XiaotianGuan/OMiGaS_KiCAD/sticker2.bmp

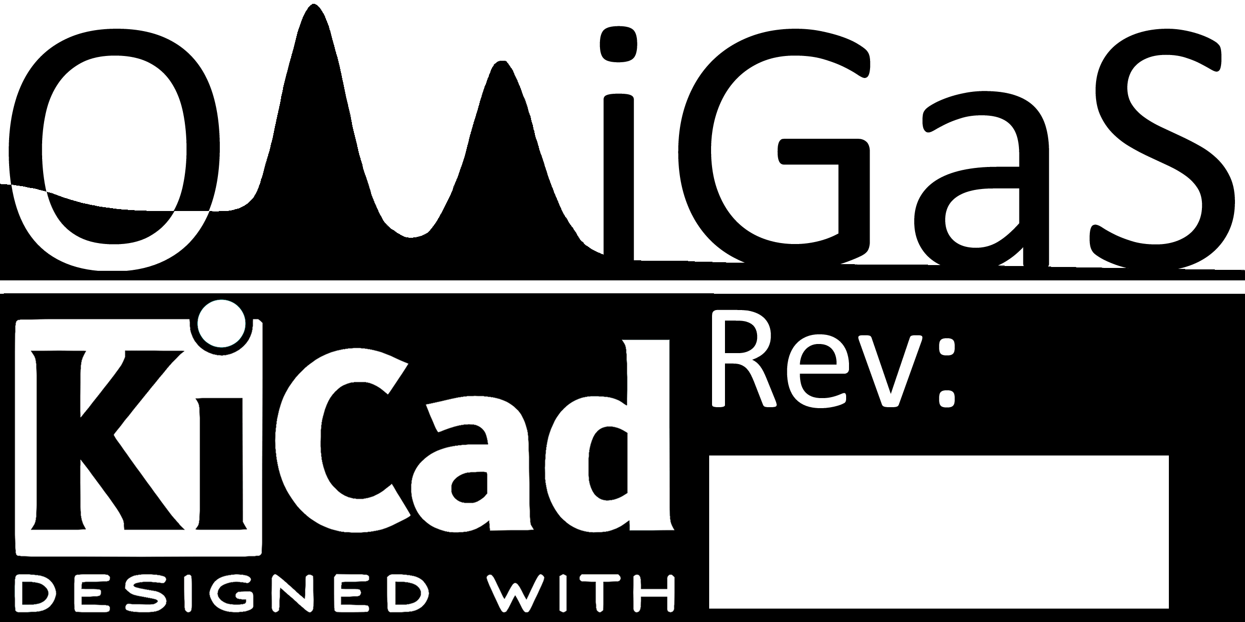
sticker2.bmp
