XiaotianGuan/OMiGaS_KiCAD/urlm.bmp

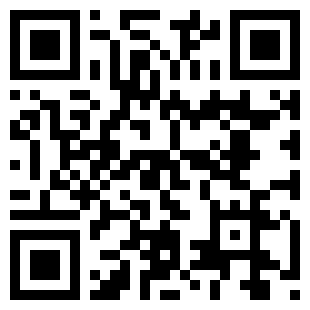
urlm.bmp
