XiaotianGuan/OMiGaS_KiCAD/OMiGaS_3D/SMB-vertical.step

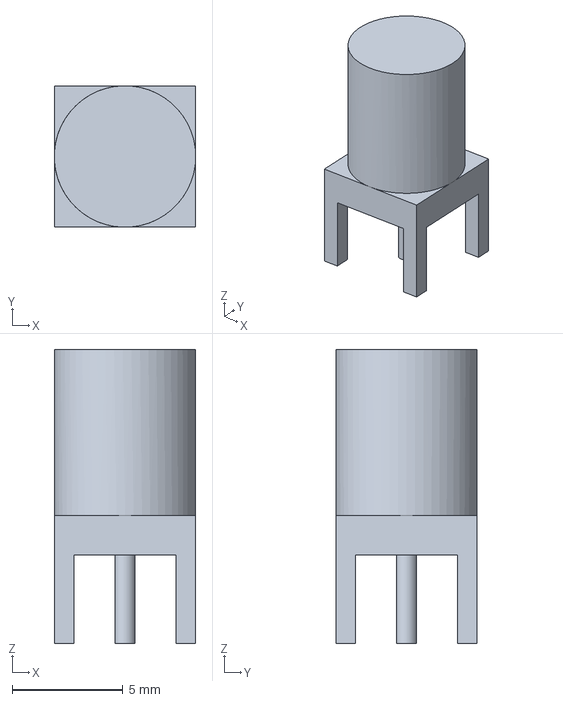
[picture p3: CAD file, 2024-07-17]
OMiGaS_3D/SMB-vertical.step
6.40 x 6.40 x 13.3 mm
