XiaotianGuan/OMiGaS_KiCAD/OMiGaS_3D/LT3462.stp

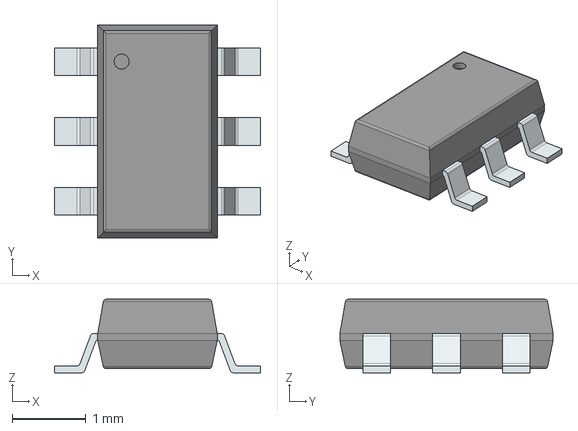
[picture p4: CAD file, 2024-07-17]
OMiGaS_3D/LT3462.stp
2.80 x 2.90 x 1.00 mm
PinsArrayLR
