XiaotianGuan/OMiGaS_KiCAD/OMiGaS_3D/M24Cxx.stp

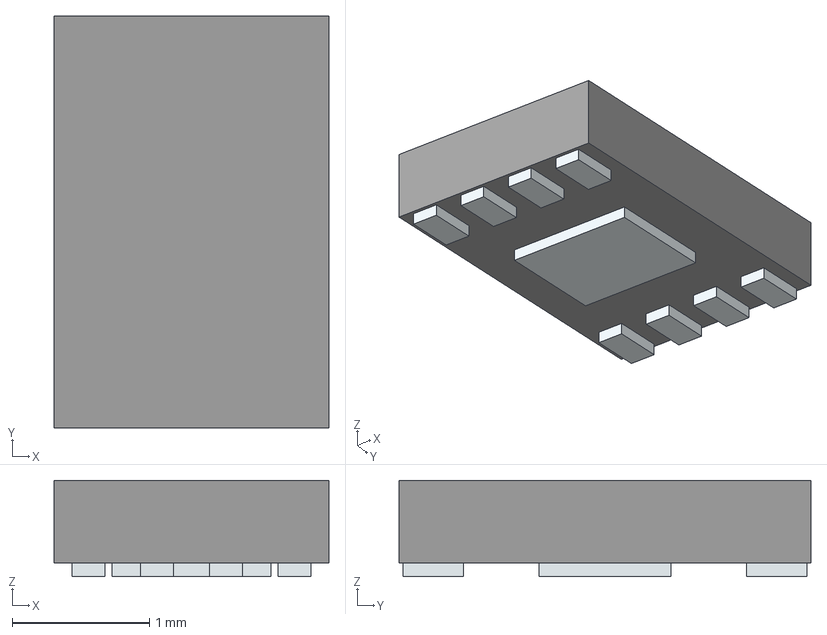
[picture p5: CAD file, 2024-07-17]
OMiGaS_3D/M24Cxx.stp
2.00 x 3.00 x 0.7 mm
Pins
