XiaotianGuan/OMiGaS_KiCAD/OMiGaS_3D/74LVC1G17.stp

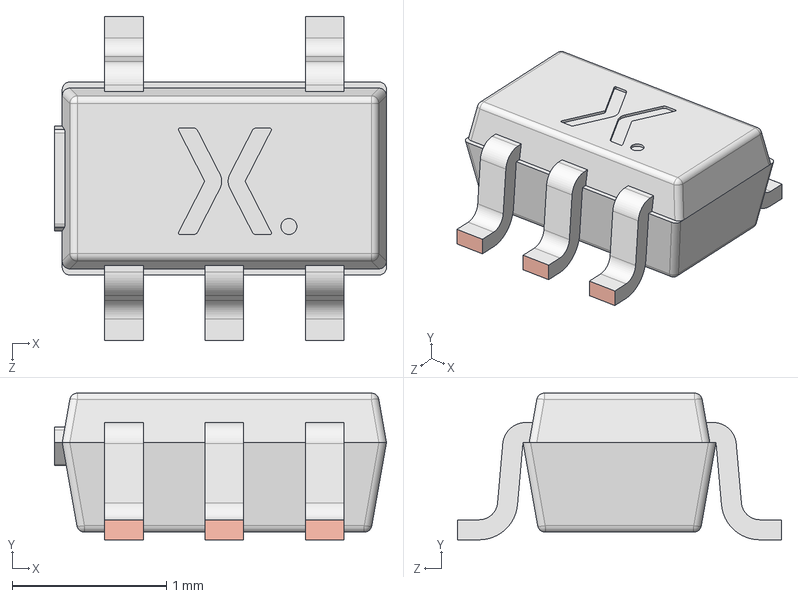
[picture p6: CAD file, 2024-07-17]
OMiGaS_3D/74LVC1G17.stp
2.15 x 0.95 x 2.10 mm
SOT353-1 Lower body
SOT353-1 Lead x 5
SOT353-1 Upper body
