XiaotianGuan/OMiGaS_KiCAD/OMiGaS_3D/MICROFC-60035.STEP

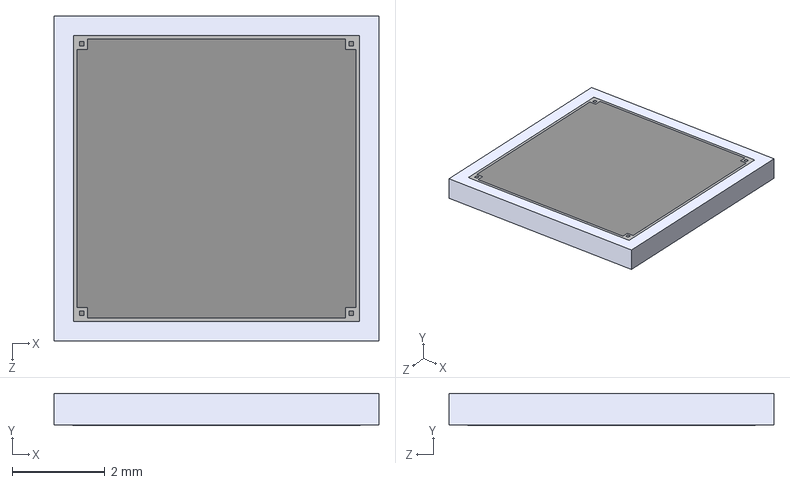
[picture p7: CAD file, 2024-07-17]
OMiGaS_3D/MICROFC-60035.STEP
7.00 x 0.7 x 7.00 mm
