XiaotianGuan/OMiGaS_KiCAD/OMiGaS_3D/TMP117.stp

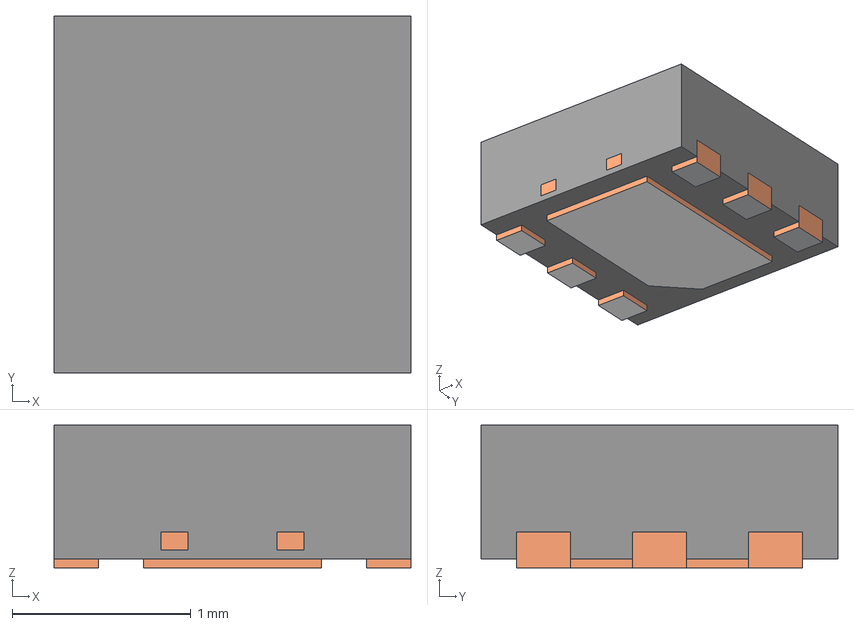
[picture p8: CAD file, 2024-07-17]
OMiGaS_3D/TMP117.stp
2.00 x 2.00 x 0.8 mm
BODY-SON
FRAME-DRV0006A
PIN1-ID
