XiaotianGuan/OMiGaS_KiCAD/OMiGaS_3D/TMP6331DYAR.stp

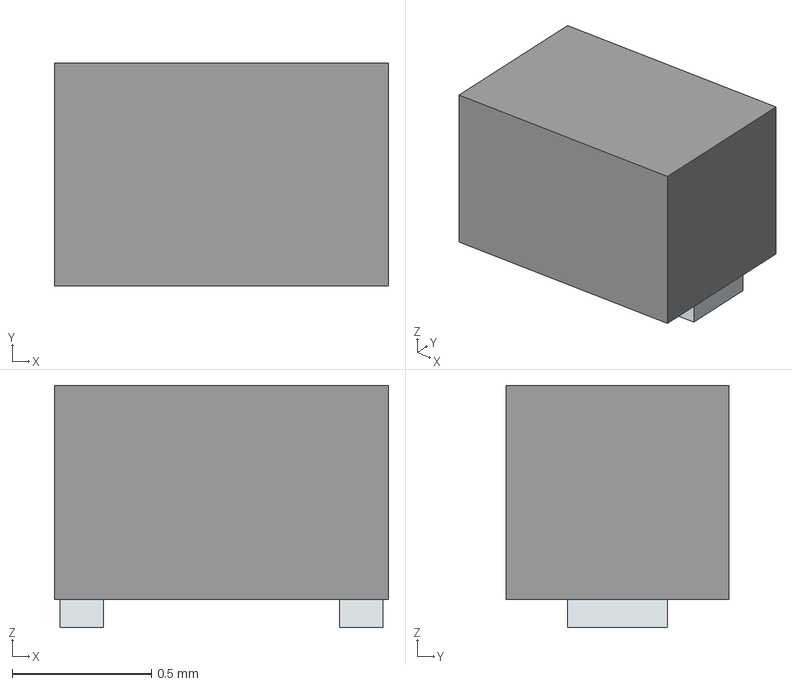
[picture p9: CAD file, 2024-07-17]
OMiGaS_3D/TMP6331DYAR.stp
1.20 x 0.8 x 0.87 mm
Pins
