XiaotianGuan/OMiGaS_KiCAD/OMiGaS_3D/VLCF5020T-470MR40.stp

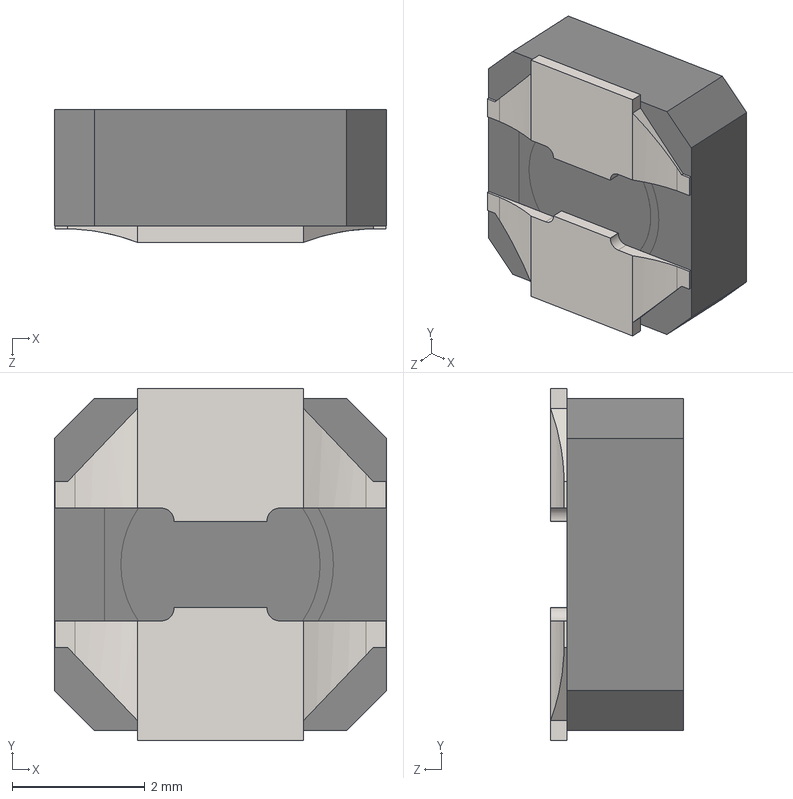
[picture p10: CAD file, 2024-07-17]
OMiGaS_3D/VLCF5020T-470MR40.stp
5.00 x 5.30 x 2.00 mm
