XiaotianGuan/OMiGaS_KiCAD/OMiGaS_3D/SW_sidemount_1P1T_3x6x3.5.step

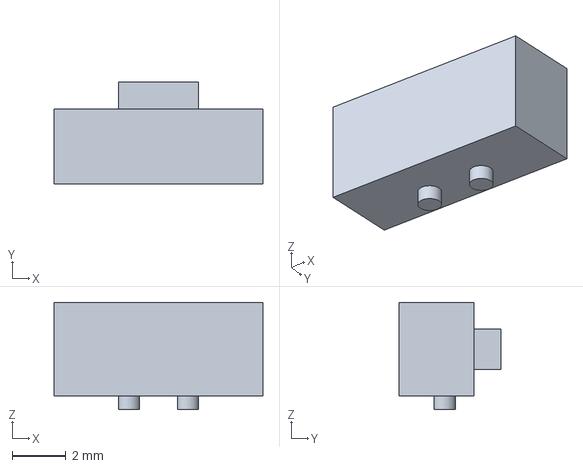
[picture p11: CAD file, 2024-07-17]
OMiGaS_3D/SW_sidemount_1P1T_3x6x3.5.step
7.80 x 3.80 x 4.00 mm
