XiaotianGuan/OMiGaS_KiCAD/OMiGaS_3D/CAT16-1003F4LF.stp

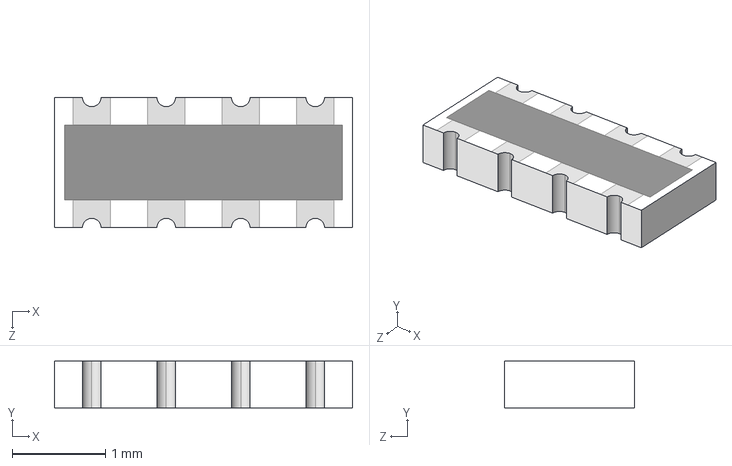
[picture p12: CAD file, 2024-07-17]
OMiGaS_3D/CAT16-1003F4LF.stp
3.20 x 0.5 x 1.40 mm
