XiaotianGuan/OMiGaS_KiCAD/OMiGaS_3D/3224W.stp

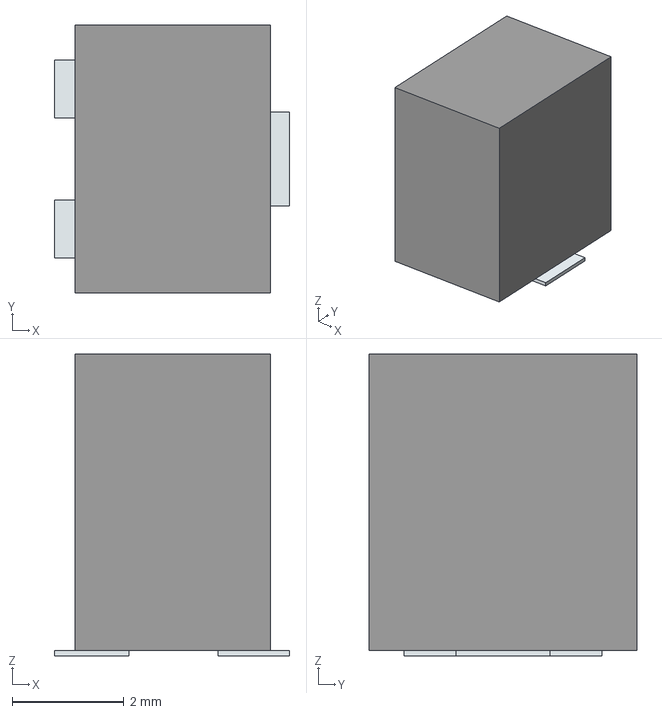
[picture p13: CAD file, 2024-07-17]
OMiGaS_3D/3224W.stp
4.21 x 4.80 x 5.40 mm
Pins
