XiaotianGuan/OMiGaS_KiCAD/OMiGaS_3D/TPS7A2045PDBVR.stp

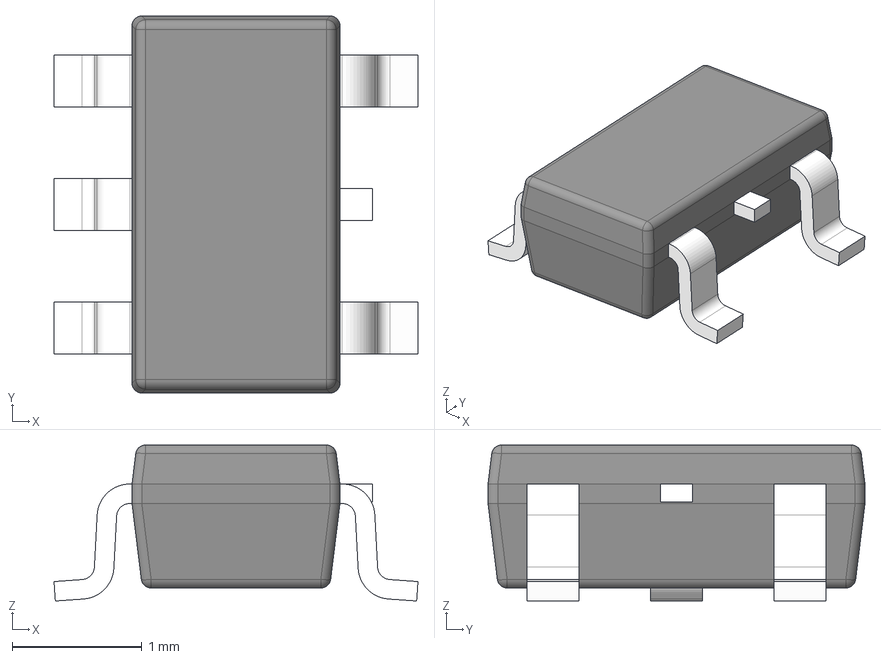
[picture p14: CAD file, 2024-07-17]
OMiGaS_3D/TPS7A2045PDBVR.stp
2.80 x 2.90 x 1.20 mm
BODY-SOT
LEAD-SOT x 5
LEAD-DUMMY
