XiaotianGuan/OMiGaS_KiCAD/OMiGaS_3D/detector-casing.step

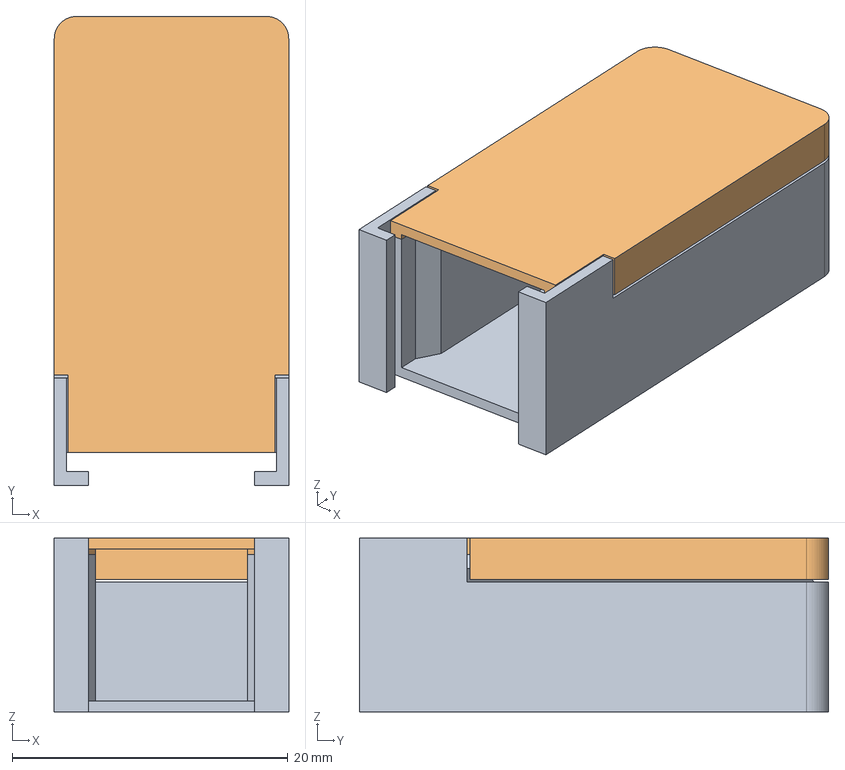
[picture p15: CAD file, 2024-07-17]
OMiGaS_3D/detector-casing.step
17.0 x 34.0 x 12.6 mm
detector-bottom
detector-top
