XiaotianGuan/OMiGaS_KiCAD/OMiGaS_3D/thumbwheel_3p.step

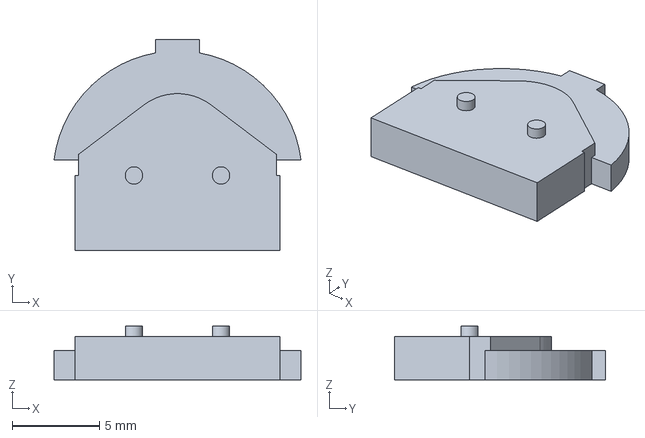
[picture p16: CAD file, 2024-07-17]
OMiGaS_3D/thumbwheel_3p.step
14.2 x 12.1 x 3.10 mm
