XiaotianGuan/OMiGaS_KiCAD/OMiGaS_3D/epd-2in66.step

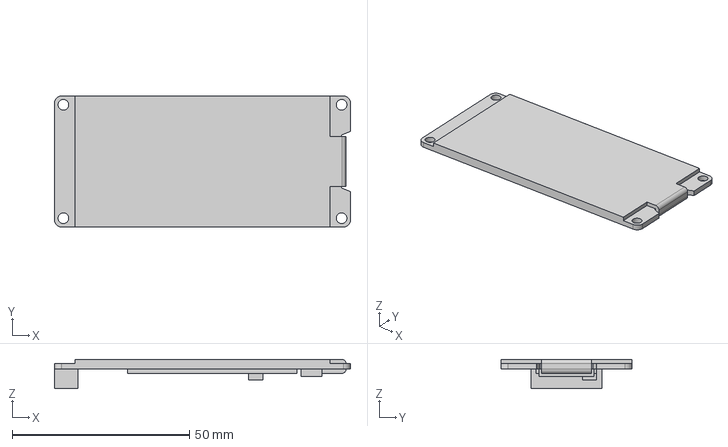
[picture p17: CAD file, 2024-07-17]
OMiGaS_3D/epd-2in66.step
83.5 x 37.0 x 8.30 mm
