XiaotianGuan/OMiGaS_KiCAD/OMiGaS_3D/MCP6006R.stp

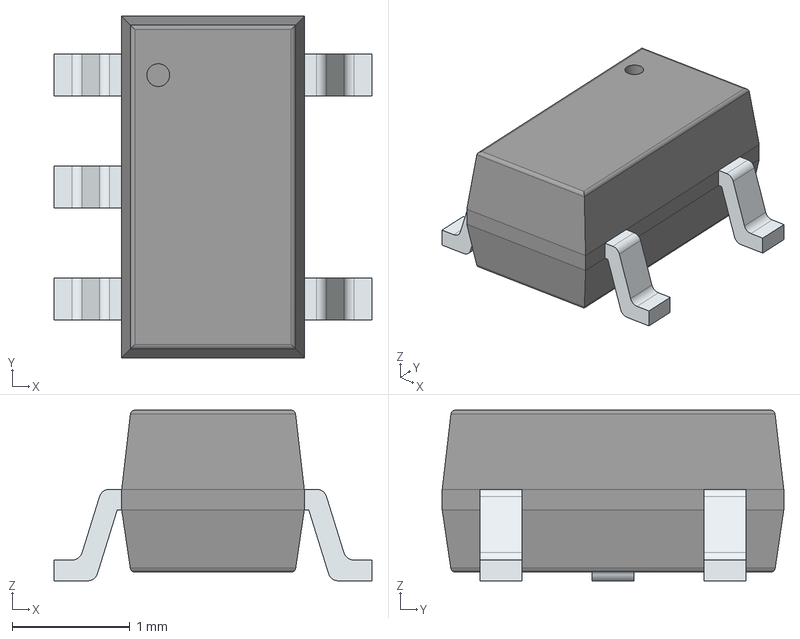
[picture p18: CAD file, 2024-07-17]
OMiGaS_3D/MCP6006R.stp
2.70 x 2.90 x 1.45 mm
PinsArrayL
PinsArrayR
