XiaotianGuan/OMiGaS_KiCAD/OMiGaS_3D/Buzzer-0905.step

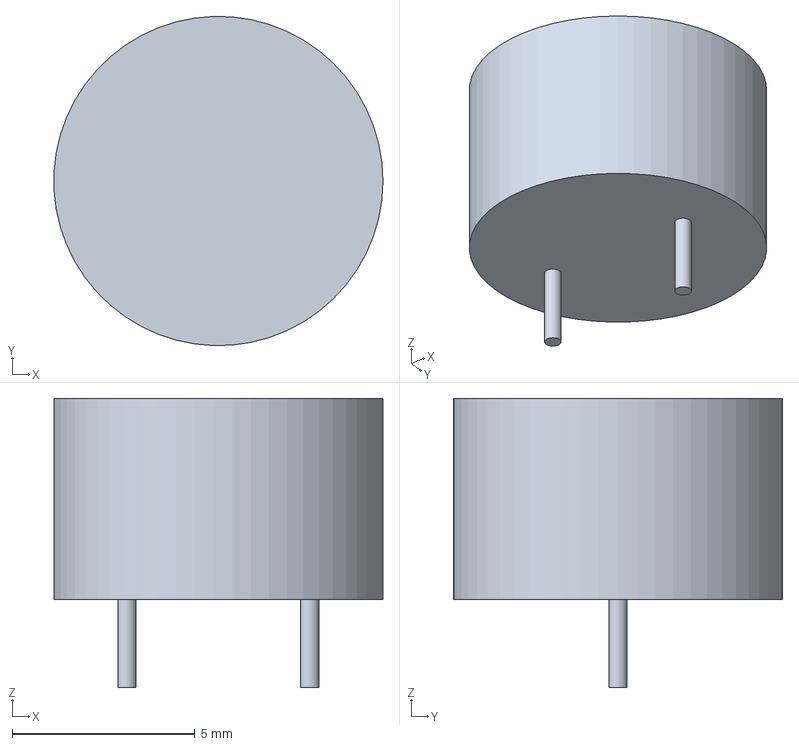
[picture p19: CAD file, 2024-07-17]
OMiGaS_3D/Buzzer-0905.step
8.99 x 9.00 x 7.90 mm
