XiaotianGuan/OMiGaS_KiCAD/OMiGaS_3D/DCT0008A.stp

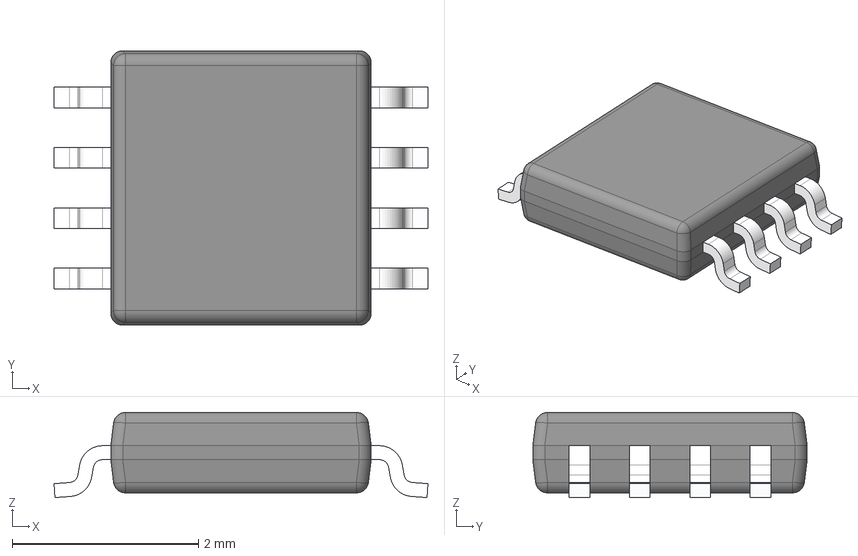
[picture p20: CAD file, 2024-07-17]
OMiGaS_3D/DCT0008A.stp
4.02 x 2.95 x 0.915 mm
BODY-SO
LEAD-SO x 8
PIN1-ID
