XiaotianGuan/OMiGaS_KiCAD/OMiGaS_3D/35W.stp

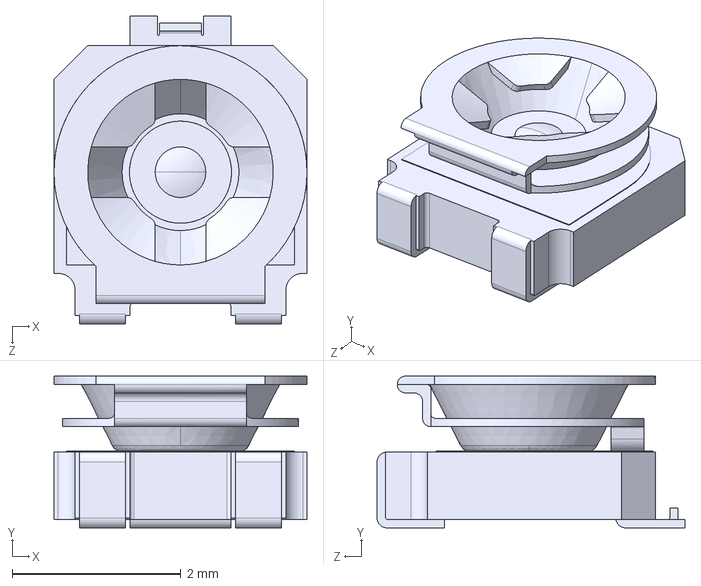
[picture p21: CAD file, 2024-07-17]
OMiGaS_3D/35W.stp
3.00 x 1.80 x 3.65 mm
