XiaotianGuan/OMiGaS_KiCAD/(list of files, cad)

Other CAD files:
OMiGaS_3D/524651070.stp
OMiGaS_3D/533091070.stp
OMiGaS_3D/MAX16150.stp
OMiGaS_3D/MAX31329.step
OMiGaS_3D/TLV61070A.stp
OMiGaS_3D/TPS22919DCKR.stp
