XiaotianGuan/OMiGaS_KiCAD/OMiGaS_schematics_v3.3.1.pdf

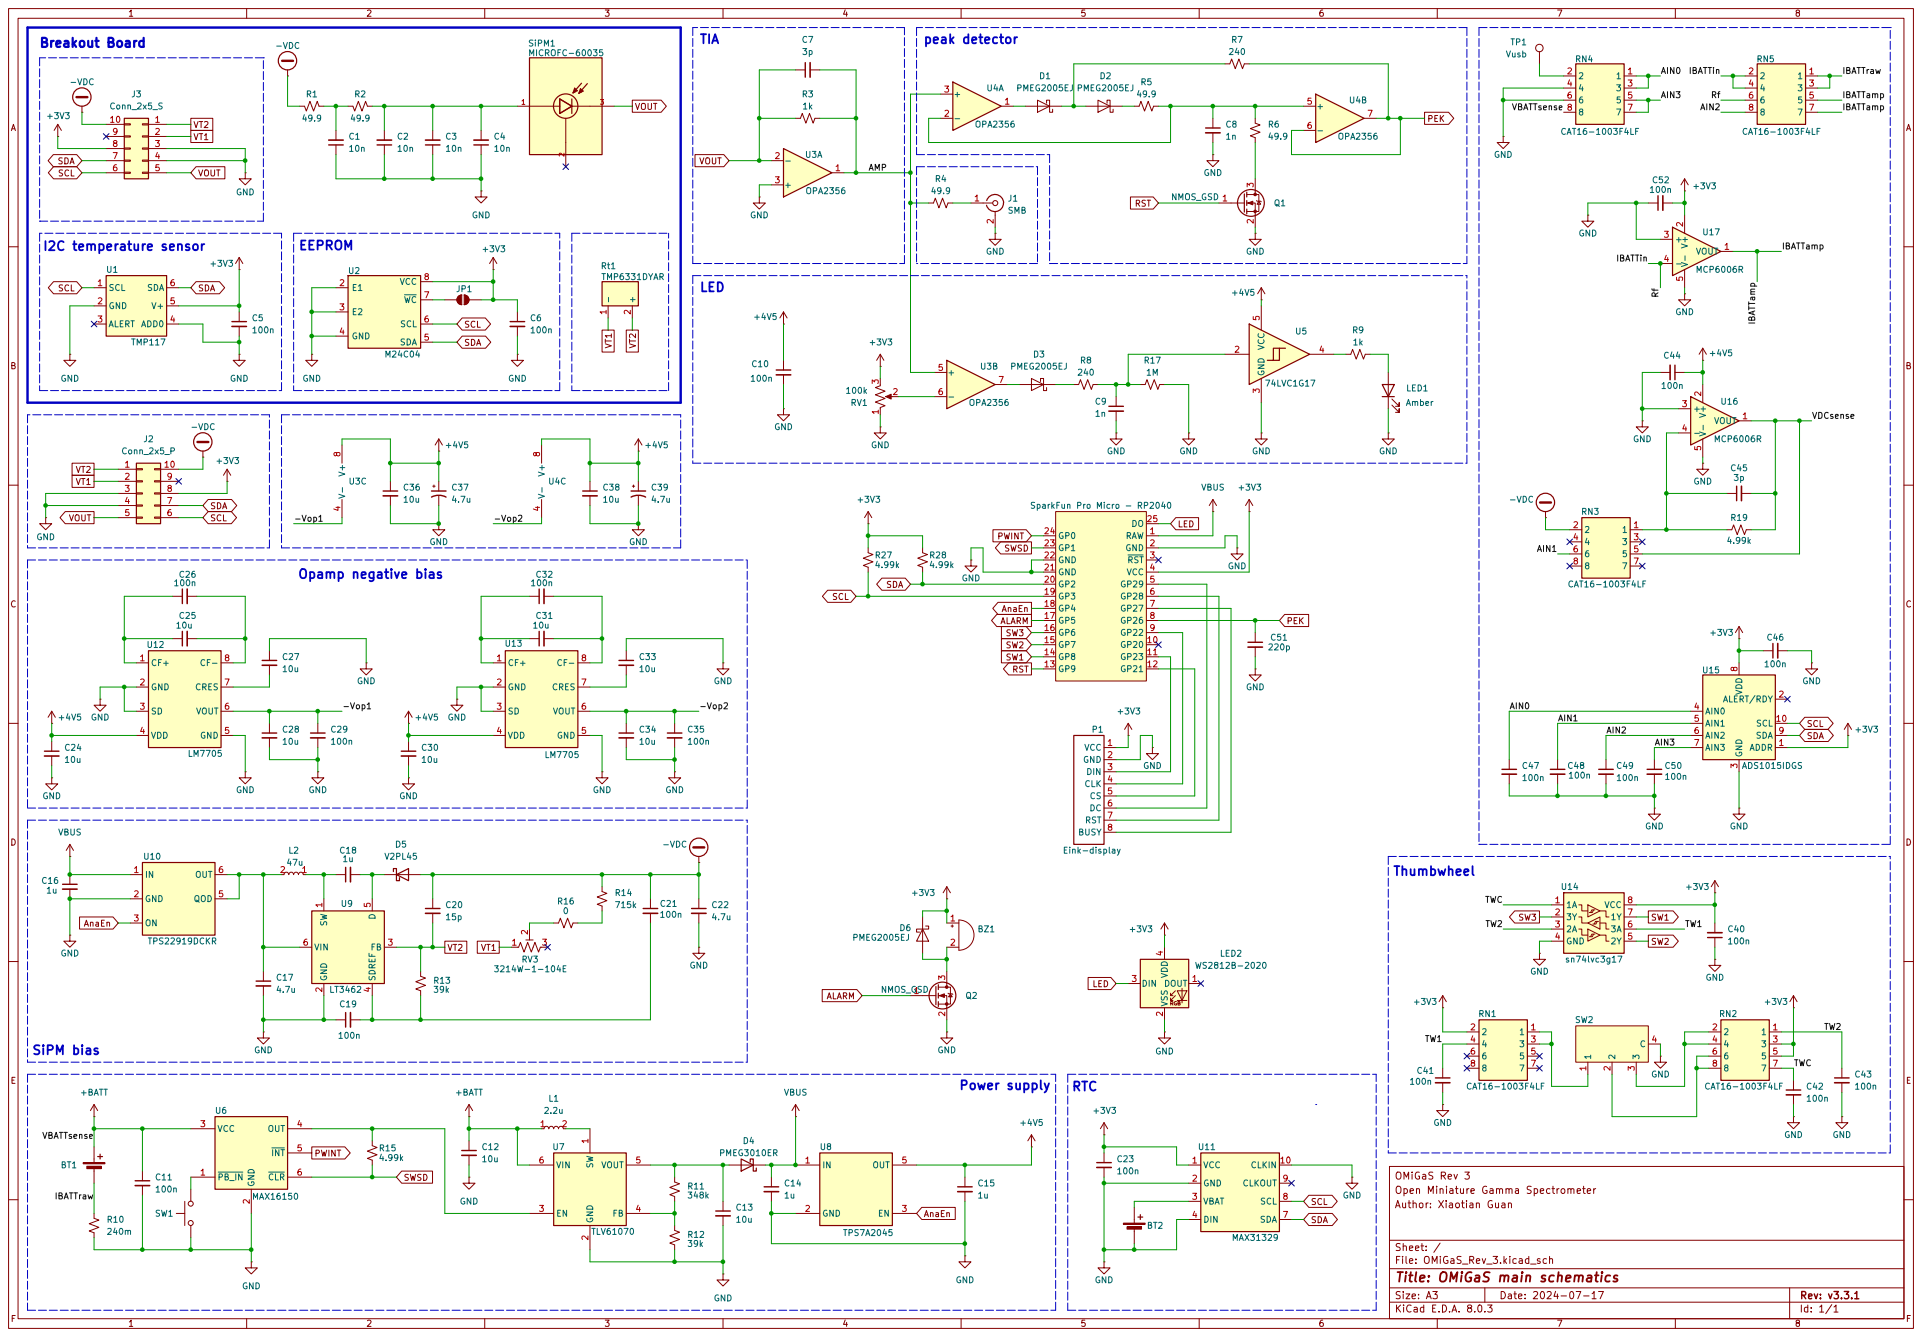
[picture p22: page 1]
