XiaotianGuan/OMiGaS_KiCAD/OMiGaS_Rev_3.kicad_pcb

## KiCad design OMiGaS_Rev_3.kicad_pcb (2024-12-22)

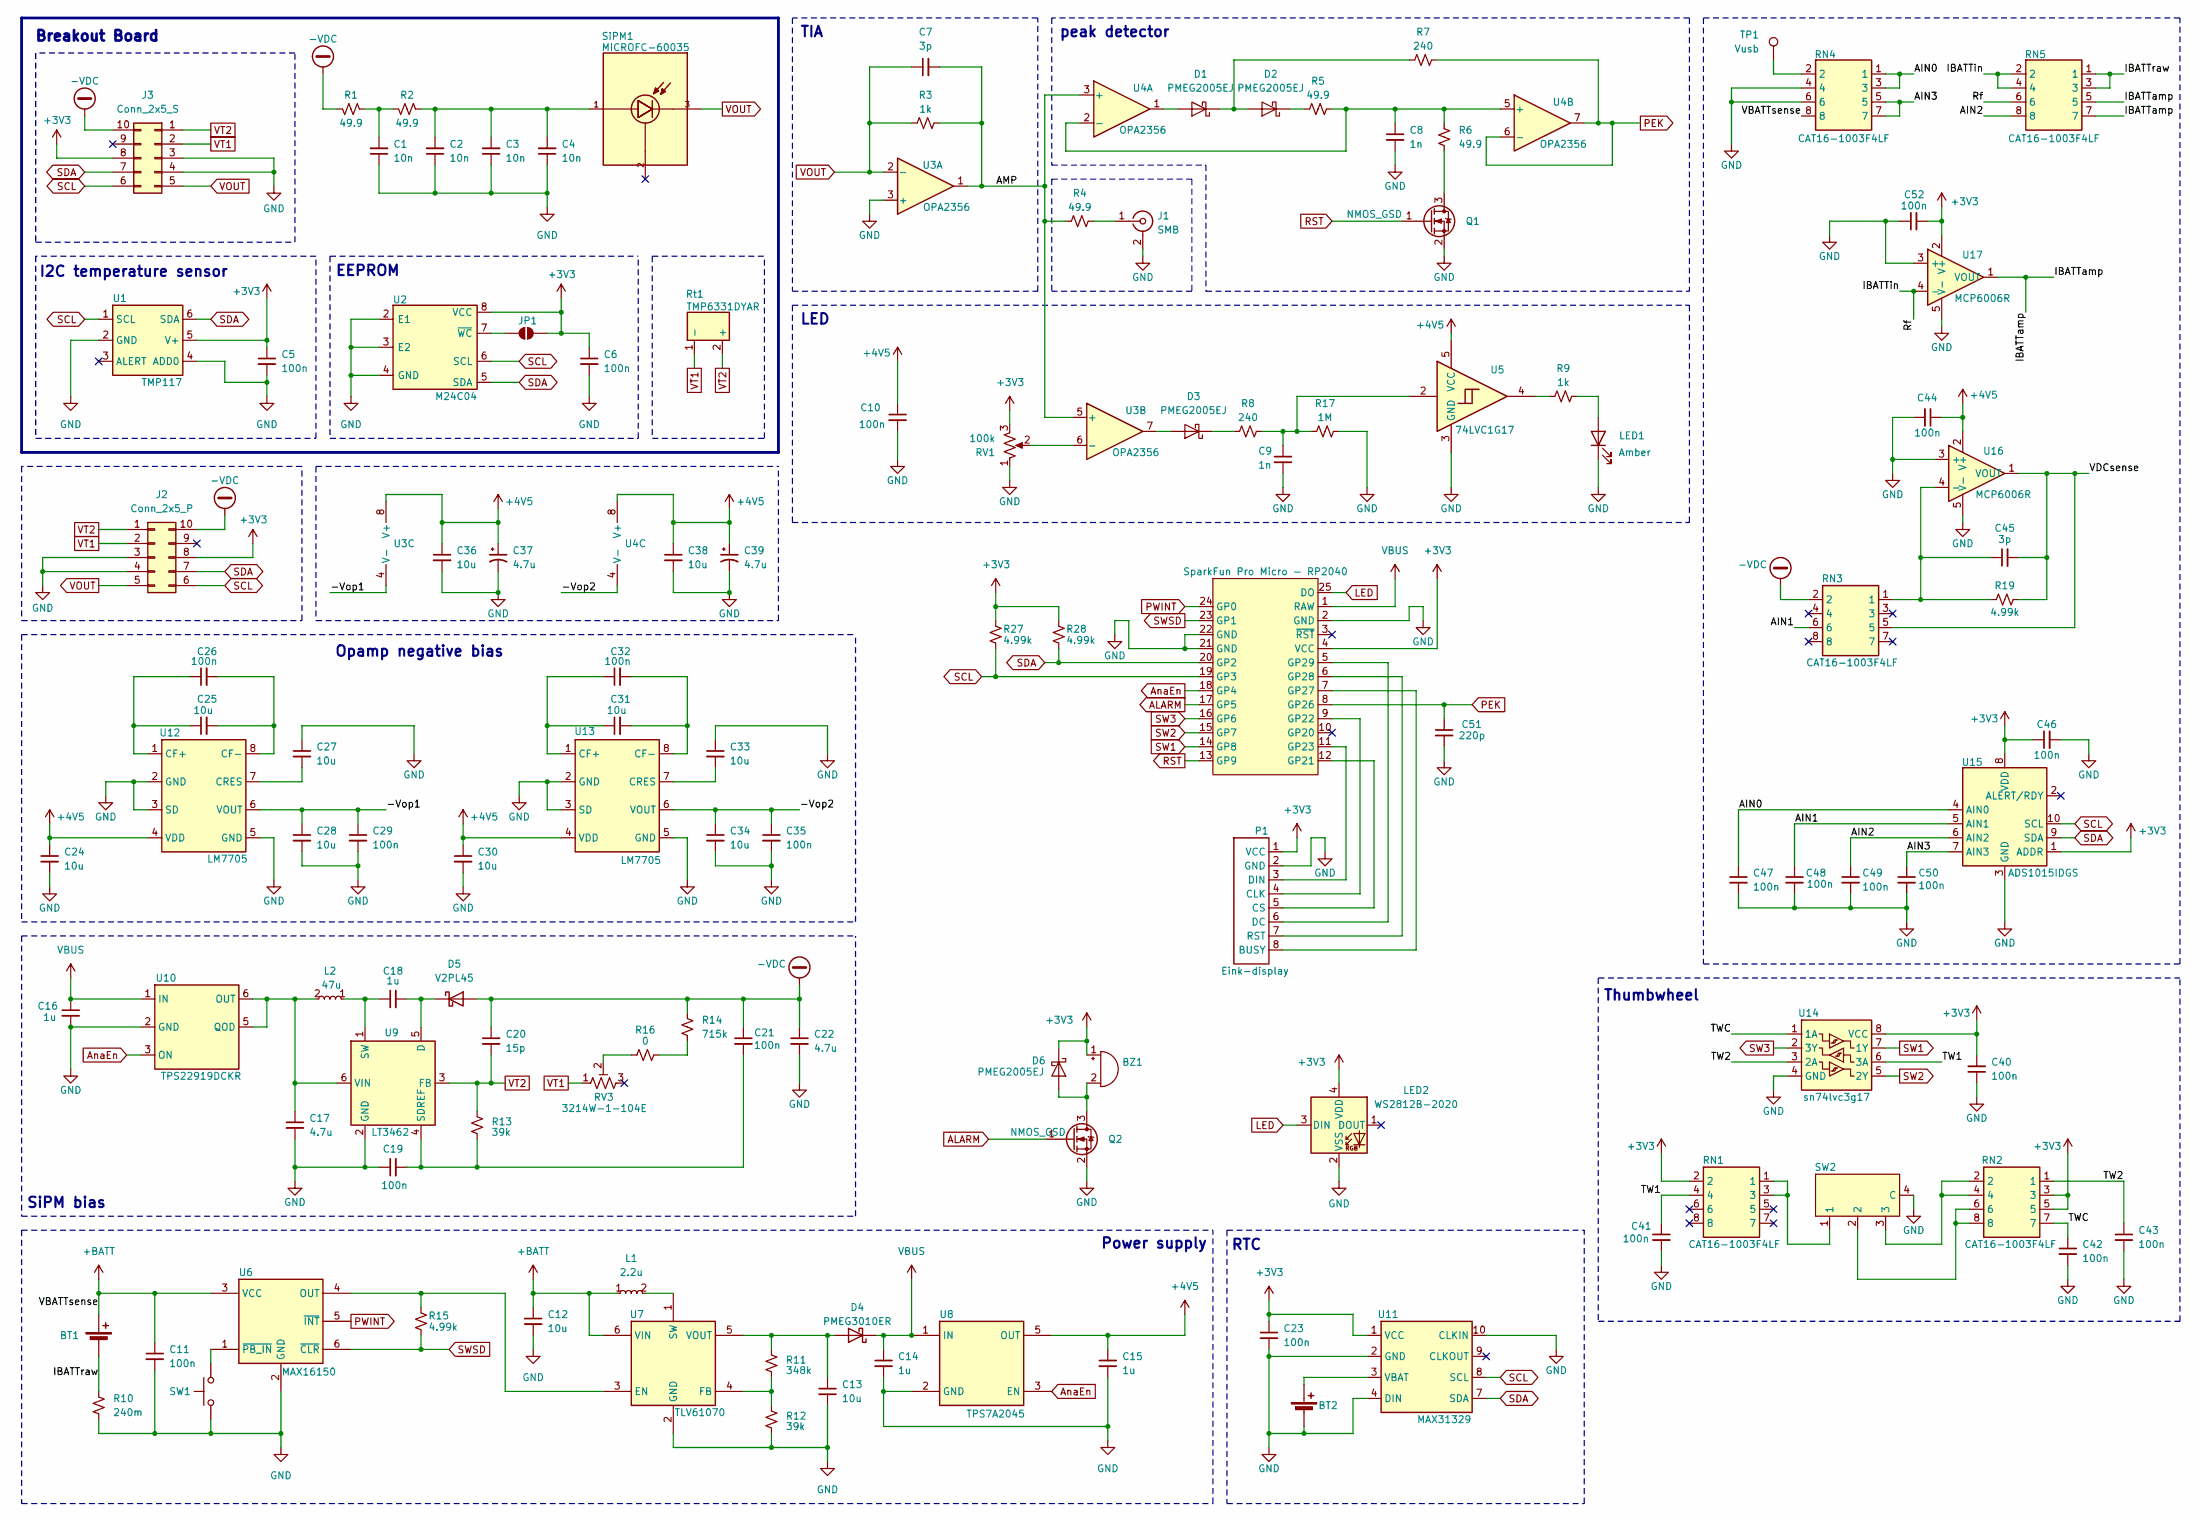
[picture p23: schematic OMiGaS_Rev_3.kicad_sch, OMiGaS main schematics]

Parts:
A1: SparkFun Pro Micro - RP2040
BT1: Battery_Cell; TestPoint_2Pads_Pitch2.54mm_Drill0.8mm
BT2: Battery_Cell; BatteryHolder_LINX_BAT-HLD-012-SMT; Manufacturer_Part_Number BAT-HLD-012-SMT
BZ1: Buzzer; Buzzer-0905
C1, C2, C3, C4: 10n; C_0603_1608Metric; Manufacturer_Part_Number C1608C0G2A103J080AC
C5, C6, C10, C11, C19, C21, C23, C26, C29, C32, C35, C40, C41, C42, C43, C44, C46, C47, C48, C49, C50, C52: 100n; C_0603_1608Metric
C7, C45: 3p; C_0603_1608Metric
C8: 1n; C_0603_1608Metric; Manufacturer_Part_Number ECH-U1C102GX5
C9: 1n; C_0603_1608Metric
C12, C13, C24, C25, C27, C28, C30, C31, C33, C34, C36, C38: 10u; C_0805_2012Metric
C14, C15, C16: 1u; C_0603_1608Metric
C17, C22: 4.7u; C_0805_2012Metric
C18: 1u; C_0805_2012Metric
C20: 15p; C_0805_2012Metric
C37, C39: 4.7u; CP_EIA-3216-18_Kemet-A; Manufacturer_Part_Number TPSA475M010R1400
C51: 220p; C_0603_1608Metric
D1, D2, D3, D6: PMEG2005EJ; D_SOD-323F; Manufacturer_Part_Number PMEG2005EJ-QX
D4: PMEG3010ER; Nexperia_CFP3_SOD-123W; Manufacturer_Part_Number PMEG3010ER,115
D5: V2PL45; D_TUMD2; Manufacturer_Part_Number V2PL45HM3/H
J1: SMB; smb-vertical
J2: Conn_2x5_P; LB100-G10P-C0R
J3: Conn_2x5_S; LB100-G10S-C0R
JP1: SolderJumper_2_Open; SolderJumper-2_P1.3mm_Open_RoundedPad1.0x1.5mm
L1: 2.2u; NRS5024T2R2NMGJ; Manufacturer_Part_Number NRS5024T2R2NMGJ
L2: 47u; VLCF5020; Manufacturer_Part_Number VLCF5020T-470MR40
LED1: Amber; LED_0603_1608Metric_Pad1.05x0.95mm_HandSolder; Manufacturer_Part_Number 150060AS75000
LED2: WS2812B-2020; LED_WS2812B-2020_PLCC4_2.0x2.0mm
P1: Eink-display; Eink_display
Q1, Q2: NMOS_GSD; SOT-23; Manufacturer_Part_Number T2N7002AK,LM
R1, R2, R4, R5, R6: 49.9; R_0805_2012Metric
R3, R9: 1k; R_0805_2012Metric
R7, R8: 240; R_0805_2012Metric
R10: 240m; R_1206_3216Metric
R11: 348k; R_0805_2012Metric
R12, R13: 39k; R_0805_2012Metric
R14: 715k; R_0805_2012Metric
R15, R19, R27, R28: 4.99k; R_0805_2012Metric
R16: 0; R_0805_2012Metric
R17: 1M; R_0805_2012Metric
RN1, RN2, RN3, RN4, RN5: CAT16-1003F4LF; CAT16104J4LF; Mouser Part Number 652-CAT16-1003F4LF
RV1: 100k; 35W; Manufacturer_Part_Number TC33X-2-104G
RV3: 3214W-1-104E; 3224W; Manufacturer_Part_Number 3214W-1-104E
Rt1: TMP6331DYAR; Mouser Part Number 595-TMP6331DYAR
SW1: SW_Push; SW_sidemount_1P1T_3x6x3.5
SW2: thumbwheel_3p
SiPM1: MICROFC-60035; PARTREV 31 JUL 2018
TP1: Vusb; TestPoint_Pad_D2.0mm
U1: TMP117; Manufacturer_Part_Number TMP117MAIDRVR
U2: M24C04; M24Cxx; Mouser Part Number 511-M24C16-FMC6TG
U3, U4: OPA2356; SO-8_3.9x4.9mm_P1.27mm; Manufacturer_Part_Number OPA2356AIDR
U5: 74LVC1G17; Manufacturer_Part_Number 74LVC1G17GW,125
U6: MAX16150; SOT95P280X145-6N; Mouser Part Number 700-MAX16150BUT+T
U7: TLV61070; SOT95P280X145-6N; Mouser Part Number 595-TLV61070ADBVR
U8: TPS7A2045; SOT95P280X145-5N; Mouser Part Number 595-TPS7A2045PDBVR
U9: LT3462; Mouser Part Number 584-LT3462ES6#TRMPBF
U10: TPS22919DCKR; Mouser Part Number 595-TPS22919DCKR
U11: MAX31329; Manufacturer_Part_Number MAX31329ELB+
U12, U13: LM7705; VSSOP-8_3.0x3.0mm_P0.65mm; Manufacturer_Part_Number LM7705MMX/NOPB
U14: sn74lvc3g17; SN74LVC3G17; Manufacturer_Part_Number SN74LVC3G17DCTRE4
U15: ADS1015IDGS; TSSOP-10_3x3mm_P0.5mm; Manufacturer_Part_Number ADS1015IDGSR
U16, U17: MCP6006R; Mouser Part Number 579-MCP6006RT-E/OT

Connections:
+3V3: A1.4 (VCC), BZ1.1 (+), C5.1, C6.1, C23.1, C40.2, C46.1, C52.2, D6.1 (K), J2.8, J3.8, JP1.2 (B), LED2.4 (VDD), P1.1 (VCC), R27.1, R28.1, RN1.2, RN2.3, RN2.5, RV1.3, U1.5 (V+), U2.8 (VCC), U11.1 (VCC), U14.8 (VCC), U15.1 (ADDR), U15.8 (VDD), U17.2 (V+)
+4V5: C10.1, C15.1, C24.1, C30.1, C36.1, C37.1, C38.1, C39.1, C44.1, U3.8 (V+), U4.8 (V+), U5.5 (VCC), U8.5 (OUT), U12.4 (VDD), U13.4 (VDD), U16.2 (V+)
+BATT: BT1.1 (+), C11.1, C12.1, L1.1, RN4.8, U6.3 (VCC), U7.6 (VIN)
-VDC: C20.1, C21.1, C22.1, D5.2 (A), J2.10, J3.10, R1.2, R14.1, RN3.2
/-Vop1: C28.1, C29.1, U3.4 (V-), U12.6 (VOUT)
/-Vop2: C34.1, C35.1, U4.4 (V-), U13.6 (VOUT)
/AIN0: C47.1, RN4.1, RN4.3, U15.4 (AIN0)
/AIN1: C48.1, RN3.6, U15.5 (AIN1)
/AIN2: C49.1, RN5.8, U15.6 (AIN2)
/AIN3: C50.1, RN4.5, RN4.7, U15.7 (AIN3)
/AMP: C7.2, R3.2, R4.1, U3.1, U3.5 (+), U4.3 (+)
/IBATTamp: RN5.5, RN5.7, U17.1 (VOUT)
/IBATTin: RN5.2, RN5.4, RN5.6, U17.4 (-)
/IBATTraw: BT1.2 (-), R10.2, RN5.1, RN5.3
/TW1: C41.1, RN1.4, U14.6 (3A)
/TW2: C43.1, RN2.1, U14.3 (2A)
/TWC: C42.1, RN2.7, U14.1 (1A)
/VDCsense: C45.2, R19.2, RN3.5, U16.1 (VOUT)
ALARM: A1.17 (GP5), Q2.1 (G)
AnaEn: A1.18 (GP4), U8.3 (EN), U10.3 (ON)
GND: A1.2 (GND), A1.21 (GND), A1.22 (GND), BT2.2 (-), C1.1, C2.1, C3.1, C4.1, C5.2, C6.2, C8.2, C9.2, C10.2, C11.2, C12.2, C13.2, C14.2, C15.2, C16.2, C17.2, C19.1, C22.2, C23.2, C24.2, C27.1, C28.2, C29.2, C30.2, C33.1, C34.2, C35.2, C36.2, C37.2, C38.2, C39.2, C40.1, C41.2, C42.2, C43.2, C44.2, C46.2, C47.2, C48.2, C49.2, C50.2, C51.2, C52.1, J1.2 (Ext), J2.3, J2.4, J3.3, J3.4, LED1.1 (K), LED2.2 (VSS), P1.2 (GND), Q1.2 (S), Q2.2 (S), R10.1, R12.1, R17.2, RN4.4, RN4.6, RV1.1, SW1.2, SW2.4 (C), U1.2 (GND), U1.4 (ADD0), U2.2 (E1), U2.3 (E2), U2.4 (GND), U3.3 (+), U5.3 (GND), U6.2 (GND), U7.2 (GND), U8.2 (GND), U9.2 (GND), U10.2 (GND), U11.2 (GND), U11.4 (DIN), U11.10 (CLKIN), U12.2 (GND), U12.3 (SD), U12.5 (GND), U13.2 (GND), U13.3 (SD), U13.5 (GND), U14.4 (GND), U15.3 (GND), U16.3 (+), U16.5 (V-), U17.3 (+), U17.5 (V-)
LED: A1.25 (DO), LED2.3 (DIN)
unnamed: A1.12 (GP21), P1.5 (CS)
unnamed: A1.9 (GP22), P1.4 (CLK)
unnamed: A1.11 (GP23), P1.3 (DIN)
unnamed: A1.7 (GP27), P1.8 (BUSY)
unnamed: A1.6 (GP28), P1.7 (RST)
unnamed: A1.5 (GP29), P1.6 (DC)
unnamed: BT2.1 (+), U11.3 (VBAT)
unnamed: BZ1.2 (-), D6.2 (A), Q2.3 (D)
unnamed: C1.2, R1.1, R2.2
unnamed: C2.2, C3.2, C4.2, R2.1, SiPM1.1
unnamed: C9.1, R8.1, R17.1, U5.2
unnamed: D1.2 (A), U4.1
unnamed: D1.1 (K), D2.2 (A), R7.1
unnamed: D2.1 (K), R5.1
unnamed: D3.2 (A), U3.7
unnamed: D3.1 (K), R8.2
unnamed: C13.1, D4.2 (A), R11.2, U7.5 (VOUT)
unnamed: C18.2, D5.1 (K), U9.5 (D)
unnamed: J1.1 (In), R4.2
unnamed: JP1.1 (A), U2.7 (~WC)
unnamed: LED1.2 (A), R9.1
unnamed: Q1.3 (D), R6.2
unnamed: R9.2, U5.4
unnamed: R14.2, R16.2
unnamed: R16.1, RV3.2
unnamed: RN1.1, RN1.3, SW2.1
unnamed: RN2.2, RN2.4, SW2.3
unnamed: RN2.6, RN2.8, SW2.2
unnamed: RN4.2, TP1.1
unnamed: RV1.2, U3.6 (-)
unnamed: C8.1, R5.2, R6.1, U4.2 (-), U4.5 (+)
unnamed: R15.1, U6.4 (OUT), U7.3 (EN)
unnamed: SW1.3, U6.1 (~PB_IN)
unnamed: R11.1, R12.2, U7.4 (FB)
unnamed: L1.2, U7.1 (SW)
unnamed: C19.2, C21.2, R13.2, U9.4 (SDREF)
unnamed: C18.1, L2.1, U9.1 (SW)
unnamed: C17.1, L2.2, U9.6 (VIN), U10.5 (QOD), U10.6 (OUT)
unnamed: C25.1, C26.1, U12.1 (CF+)
unnamed: C25.2, C26.2, U12.8 (CF-)
unnamed: C27.2, U12.7 (CRES)
unnamed: C31.1, C32.1, U13.1 (CF+)
unnamed: C31.2, C32.2, U13.8 (CF-)
unnamed: C33.2, U13.7 (CRES)
unnamed: C45.1, R19.1, RN3.1, U16.4 (-)
PEK: A1.8 (GP26), C51.1, R7.2, U4.6 (-), U4.7
PWINT: A1.24 (GP0), U6.5 (~INT)
RST: A1.13 (GP9), Q1.1 (G)
SCL: A1.19 (GP3), J2.6, J3.6, R27.2, U1.1 (SCL), U2.6 (SCL), U11.8 (SCL), U15.10 (SCL)
SDA: A1.20 (GP2), J2.7, J3.7, R28.2, U1.6 (SDA), U2.5 (SDA), U11.7 (SDA), U15.9 (SDA)
SW1: A1.14 (GP8), U14.7 (1Y)
SW2: A1.15 (GP7), U14.5 (2Y)
SW3: A1.16 (GP6), U14.2 (3Y)
SWSD: A1.23 (GP1), R15.2, U6.6 (~CLR)
VBUS: A1.1 (RAW), C14.1, C16.1, D4.1 (K), U8.1 (IN), U10.1 (IN)
VOUT: C7.1, J2.5, J3.5, R3.1, SiPM1.3, U3.2 (-)
VT1: J2.2, J3.2, RV3.1, Rt1.1 (-)
VT2: C20.2, J2.1, J3.1, R13.1, Rt1.2 (+), U9.3 (FB)

Notes on the sheet:
Power supply
RTC
peak detector
Breakout Board
Thumbwheel
I2C temperature sensor
Opamp negative bias
TIA
EEPROM
LED
SiPM bias

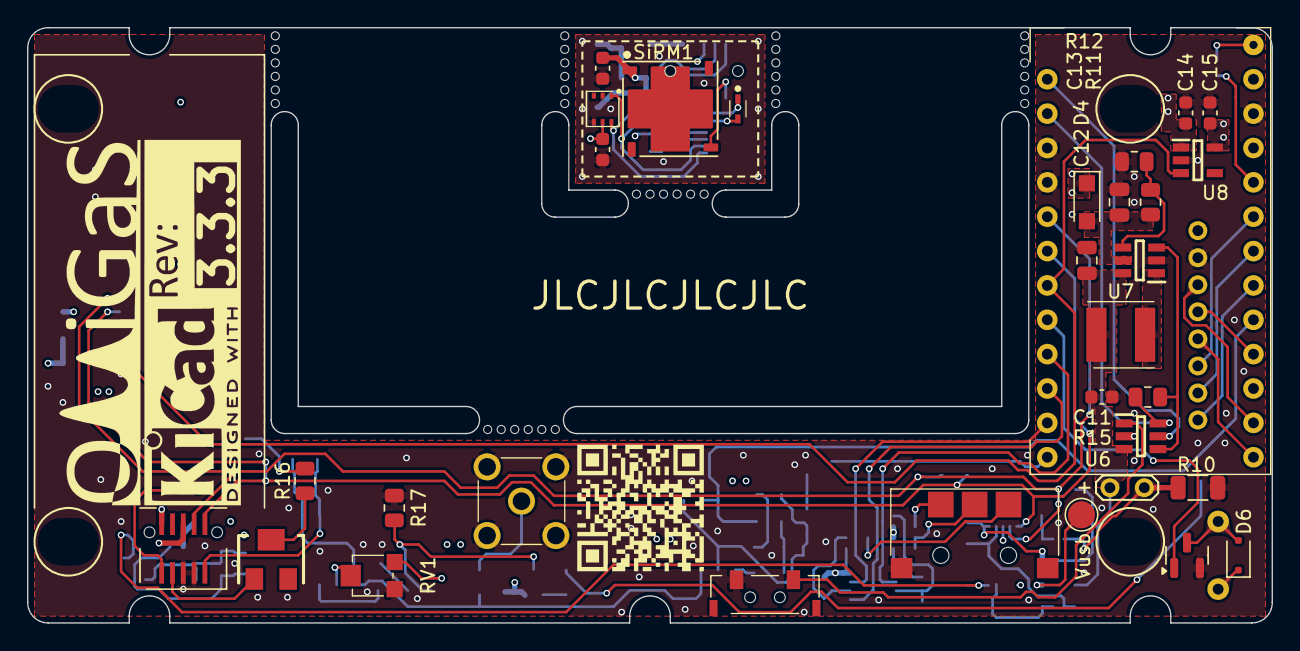
[picture p24: board OMiGaS_Rev_3.kicad_pcb from above]

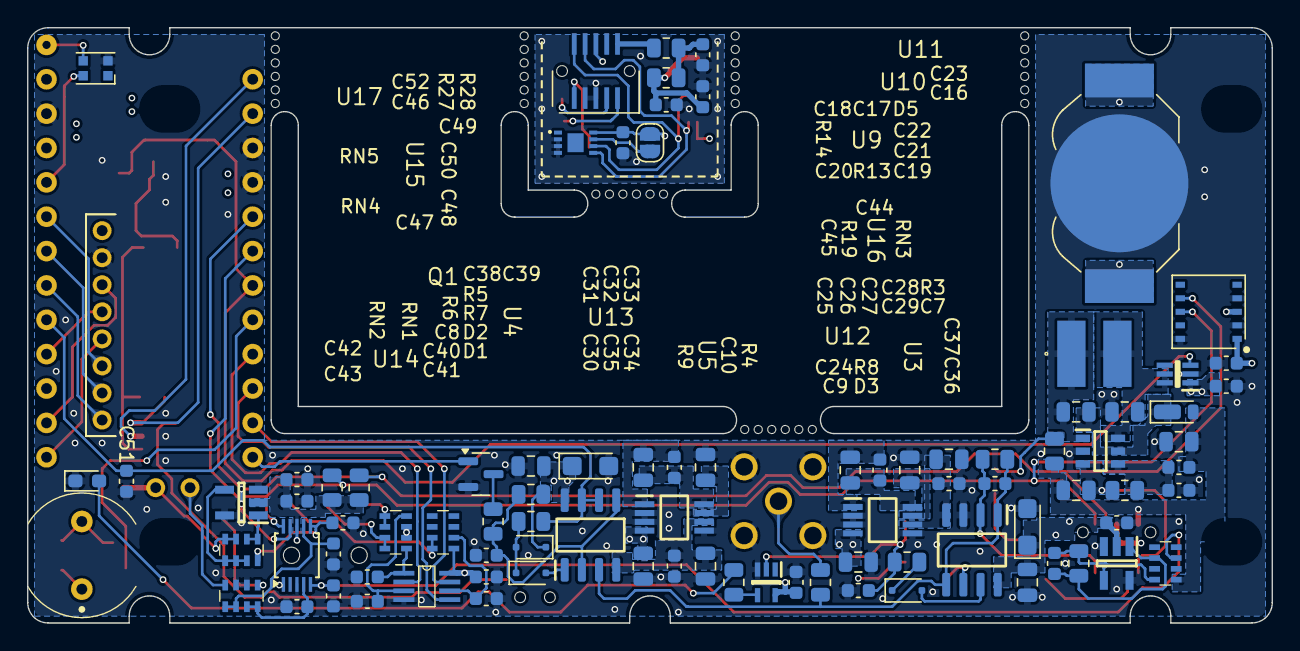
[picture p25: board OMiGaS_Rev_3.kicad_pcb from below]

Board: 4 copper layers, 92.0 x 44.0 mm, 122 parts (90 on the bottom side), 80 nets.
