XiaotianGuan/OMiGaS_KiCAD/(commit log)

2024-07-17 v3.3.1 initial commit
    [3224W.stp, 35W.stp, 74LVC1G17.stp, Buzzer-0905.step, CAT16-1003F4LF.stp, DCT0008A.stp, LT3462.stp, M24Cxx.stp]
2024-10-01 Added BOM, optimized trim pot position, re-generated gerber
    [OMiGaS_Rev_3-BOM.csv, OMiGaS_Rev_3.kicad_pcb, OMiGaS_Rev_3.kicad_sch]
2024-10-02 Updated BOM, added 3d model for B2B connector, corrected detector shell position
    [524651070.stp, 533091070.stp, OMiGaS_Rev_3-BOM.csv, OMiGaS_Rev_3.kicad_pcb, OMiGaS_Rev_3.kicad_sch]
2024-10-03 updated BOM
    [OMiGaS_Rev_3-BOM.csv, OMiGaS_Rev_3.kicad_sch]
2024-10-03 fixed typo in BOM
    [OMiGaS_Rev_3-BOM.csv, OMiGaS_Rev_3.kicad_sch]
2024-10-04 edited schematics signature
    [OMiGaS_Rev_3.kicad_sch]
2024-12-22 changed to through hole pogo pin, improved ground stitching
    [OMiGaS_Rev_3.kicad_pcb]
